EIectron/BATF7-Brushed-FC/README.md

# BATF7-Brushed-FC
 STM32F722 Based brushed flight controller board
