EIectron/BATF7-Brushed-FC/Hardware/IMAGEs/BATF7_SVG/bottom.png

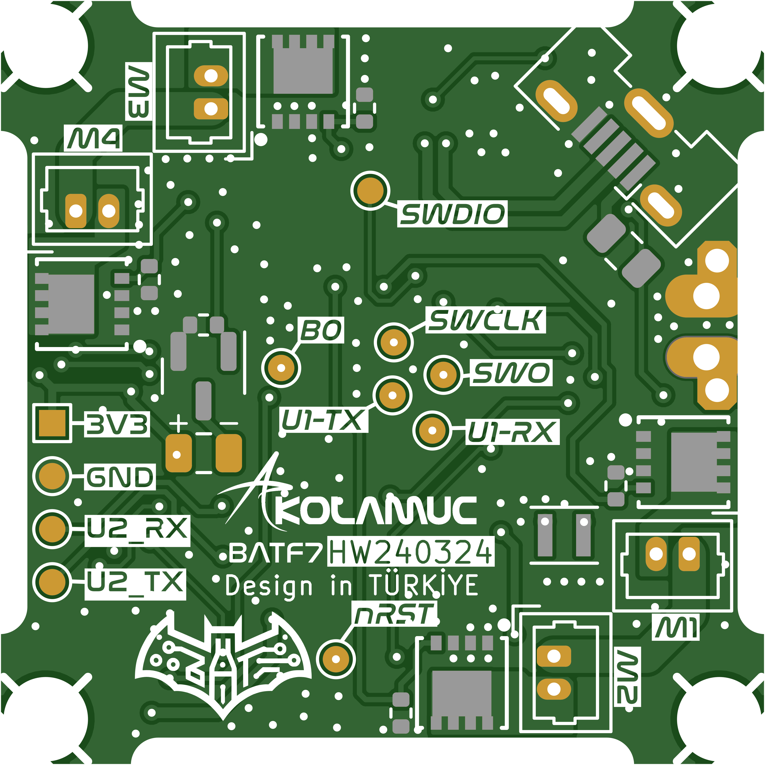
Hardware/IMAGEs/BATF7_SVG/bottom.png
