EIectron/BATF7-Brushed-FC/Hardware/IMAGEs/BATF7_SVG/top.png

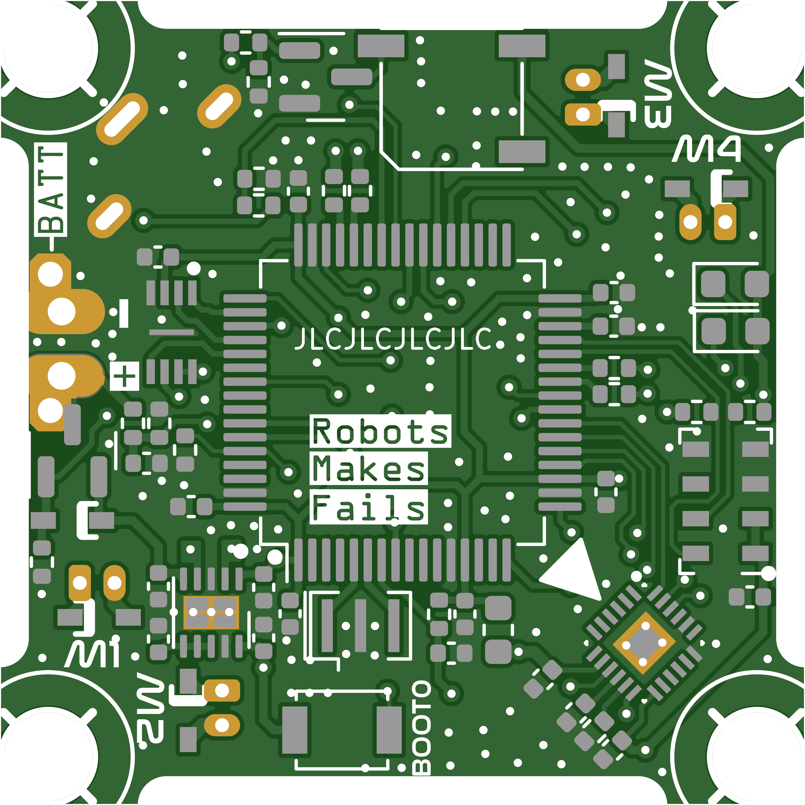
Hardware/IMAGEs/BATF7_SVG/top.png
