EIectron/BATF7-Brushed-FC/Hardware/IMAGEs/Render/Bot.png

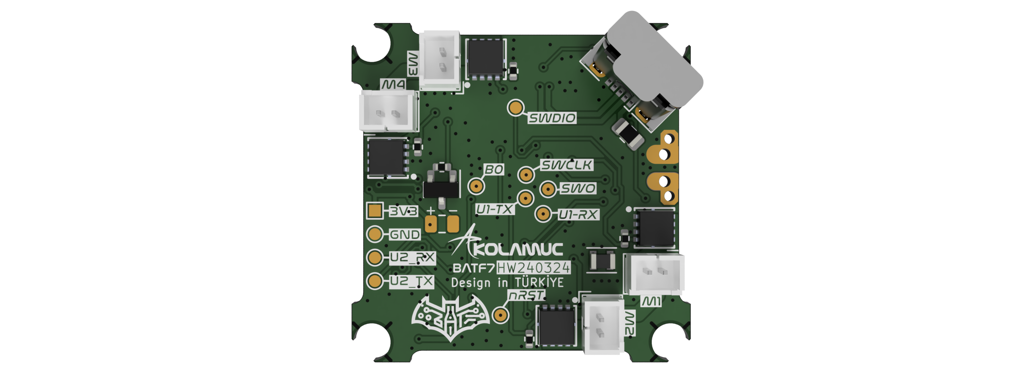
Hardware/IMAGEs/Render/Bot.png
