EIectron/BATF7-Brushed-FC/Hardware/IMAGEs/Render/Top.png

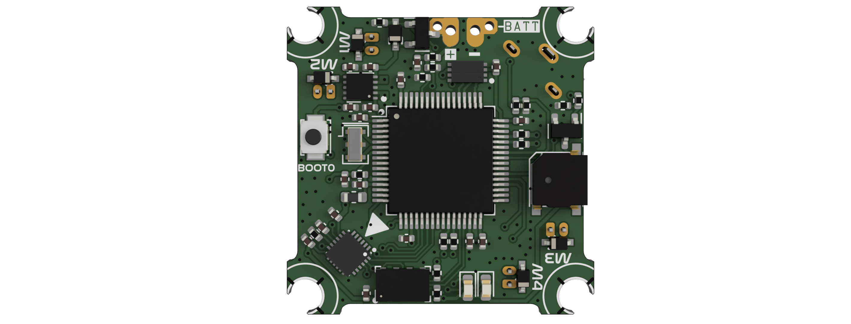
Hardware/IMAGEs/Render/Top.png
