EIectron/BATF7-Brushed-FC/Hardware/IMAGEs/SIS434DN-PSUM.PNG

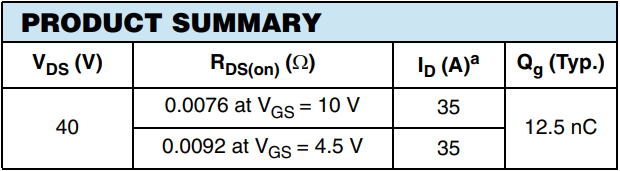
Hardware/IMAGEs/SIS434DN-PSUM.PNG
