EIectron/BATF7-Brushed-FC/Hardware/3D/Coilcraft_XFL4015 v11.step

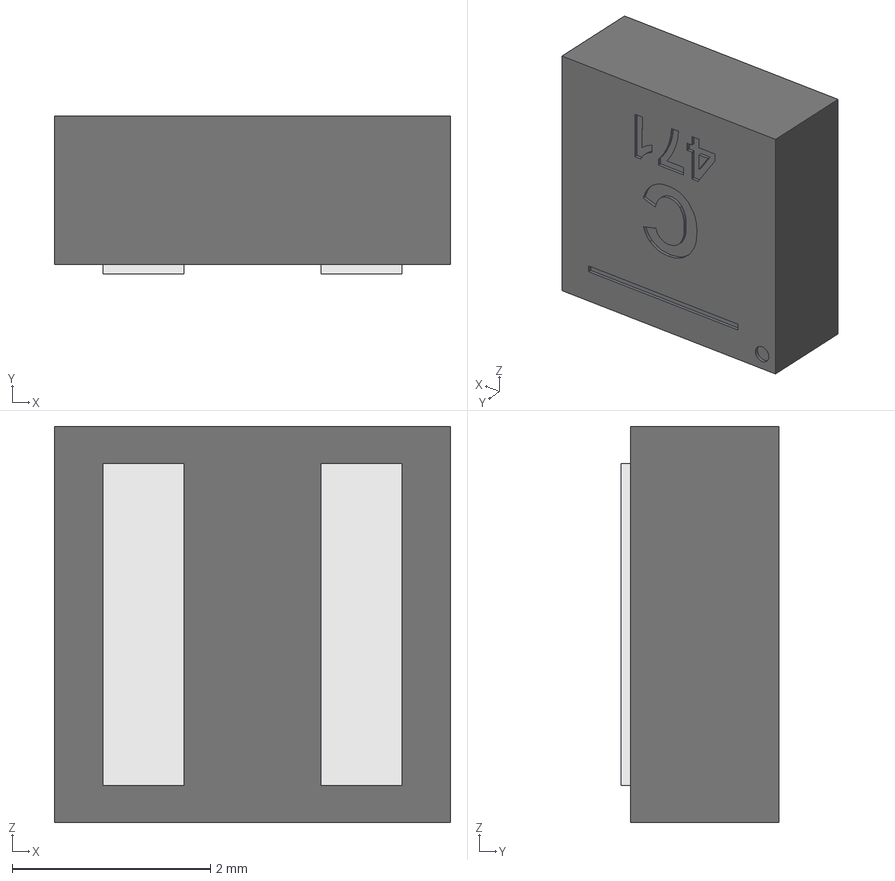
[picture p7: CAD file, 2024-04-10]
Hardware/3D/Coilcraft_XFL4015 v11.step
4.00 x 1.60 x 4.00 mm
base
