EIectron/BATF7-Brushed-FC/Hardware/3D/JST - GH - Thru (V) - 2Pin - 1.25mm.stp

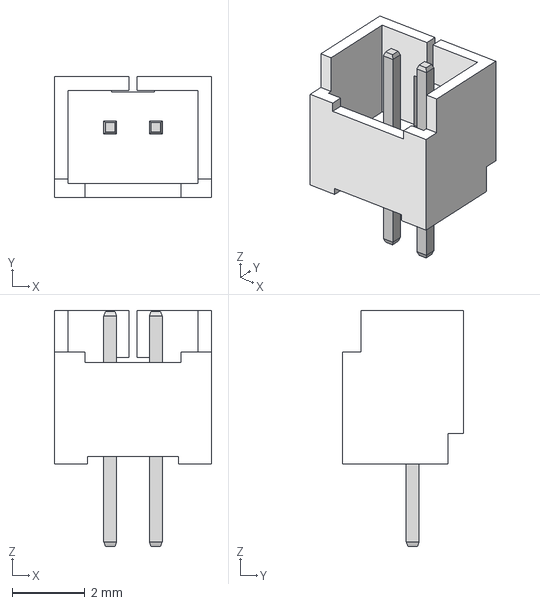
[picture p8: CAD file, 2024-04-10]
Hardware/3D/JST - GH - Thru (V) - 2Pin - 1.25mm.stp
4.32 x 3.33 x 6.48 mm
