EIectron/BATF7-Brushed-FC/Hardware/3D/DFN8_6x5.STEP

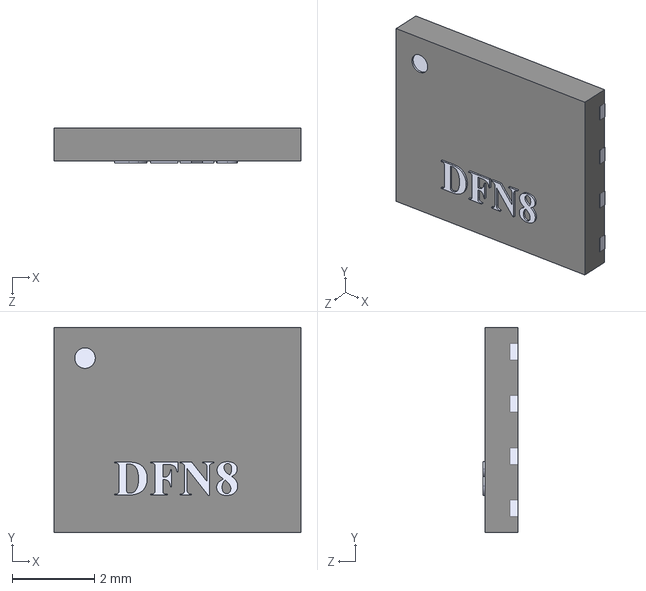
[picture p9: CAD file, 2024-04-10]
Hardware/3D/DFN8_6x5.STEP
6.01 x 5.00 x 0.855 mm
