EIectron/BATF7-Brushed-FC/Hardware/3D/ABMT-801-RC.STEP

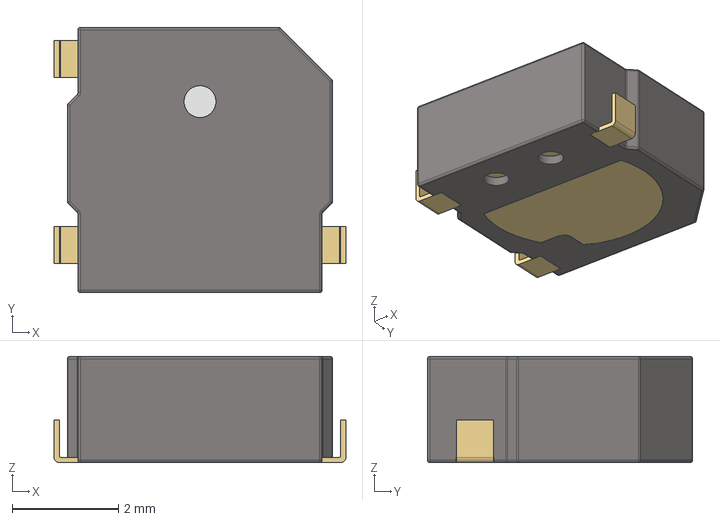
[picture p10: CAD file, 2024-04-10]
Hardware/3D/ABMT-801-RC.STEP
5.50 x 5.00 x 2.00 mm
