EIectron/BATF7-Brushed-FC/Hardware/3D/MPU-6500.STEP

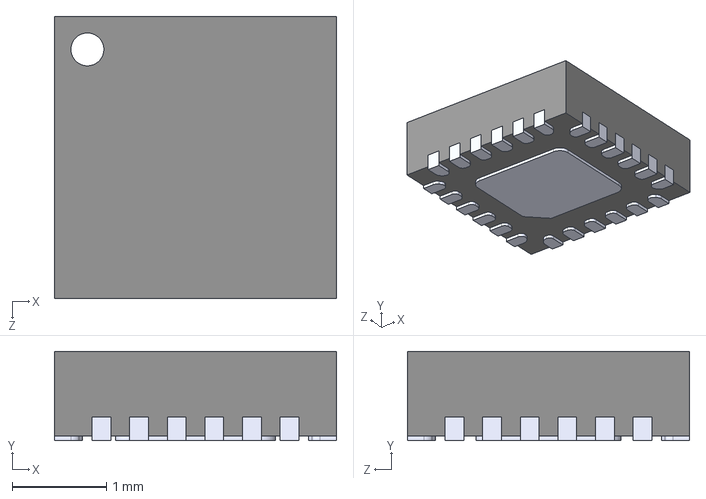
[picture p11: CAD file, 2024-04-10]
Hardware/3D/MPU-6500.STEP
3.00 x 0.95 x 3.00 mm
