EIectron/BATF7-Brushed-FC/Hardware/3D/FDMA410NZ.step

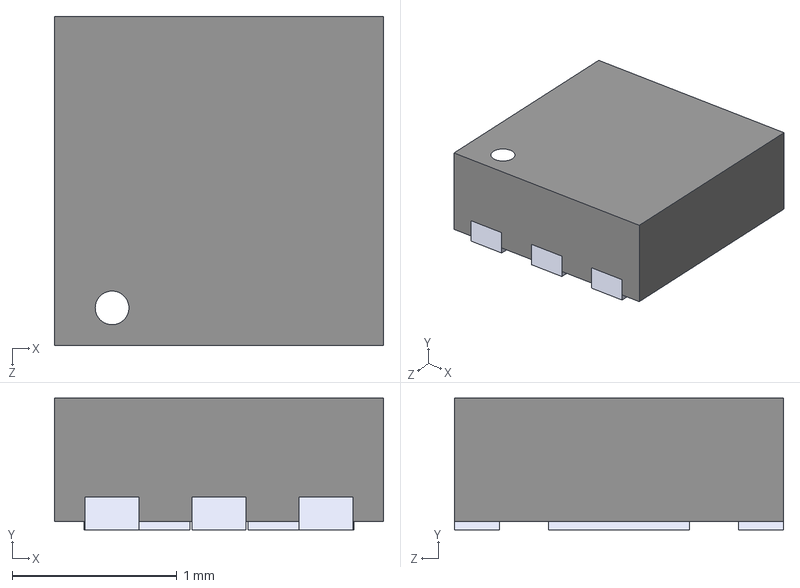
[picture p12: CAD file, 2024-04-10]
Hardware/3D/FDMA410NZ.step
2.00 x 0.8 x 2.00 mm
