EIectron/BATF7-Brushed-FC/Hardware/3D/Molex-105133-0031.stp

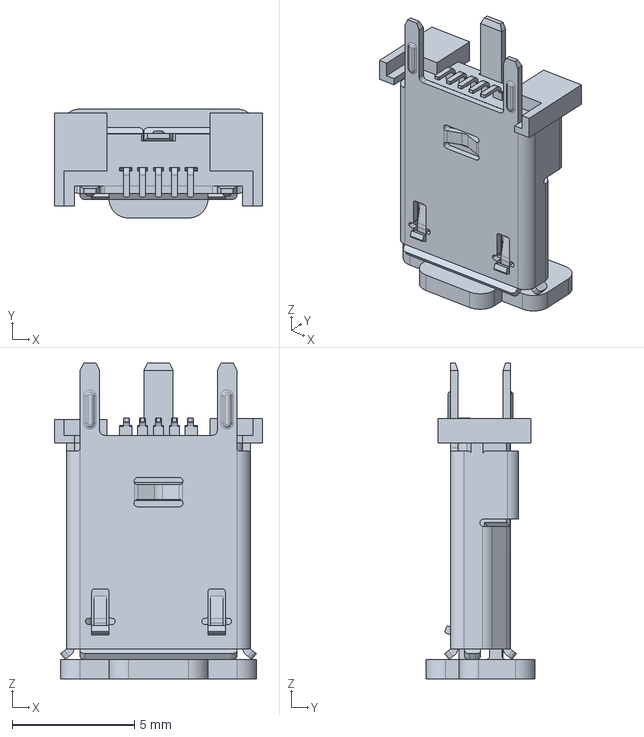
[picture p13: CAD file, 2024-04-10]
Hardware/3D/Molex-105133-0031.stp
8.50 x 4.45 x 12.9 mm
