EIectron/BATF7-Brushed-FC/Hardware/3D/JST - GH - Thru (R) - 2Pin - 1.25mm.stp

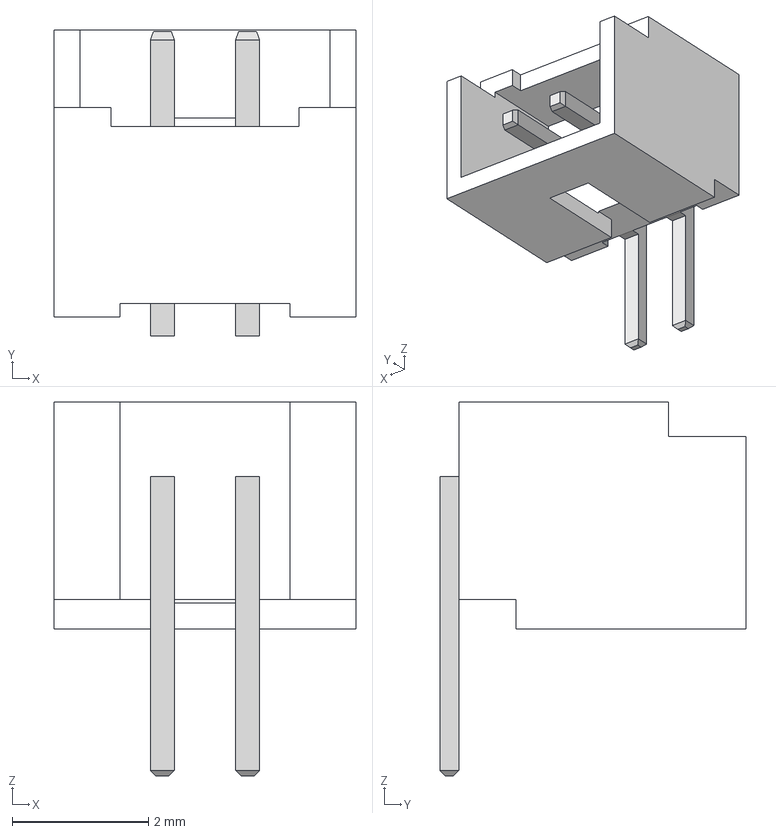
[picture p14: CAD file, 2024-04-10]
Hardware/3D/JST - GH - Thru (R) - 2Pin - 1.25mm.stp
4.43 x 4.50 x 5.49 mm
