EIectron/BATF7-Brushed-FC/Hardware/3D/W25X05CLUXIG.STEP

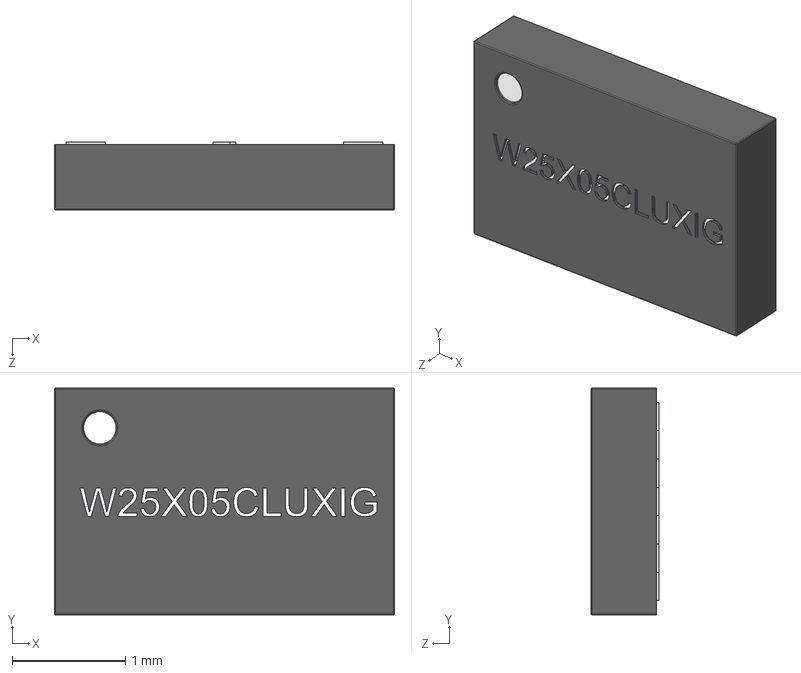
[picture p15: CAD file, 2024-04-10]
Hardware/3D/W25X05CLUXIG.STEP
3.00 x 2.00 x 0.6 mm
