EIectron/BATF7-Brushed-FC/Hardware/3D/SIS434DN-T1-GE3.STEP

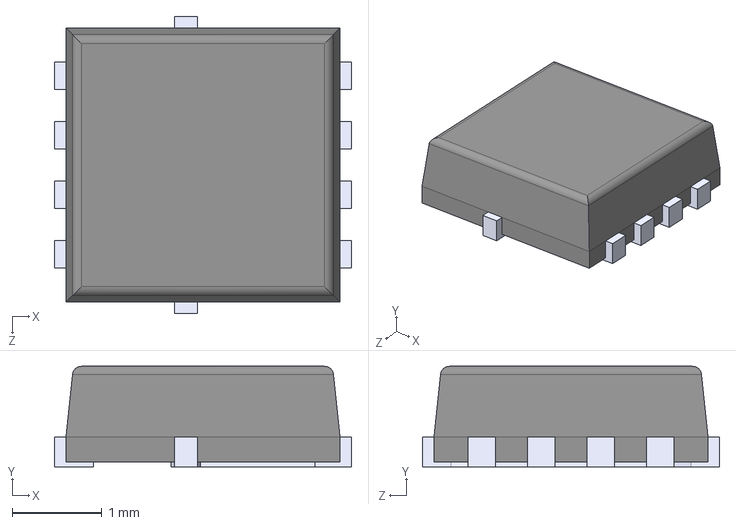
[picture p16: CAD file, 2024-04-10]
Hardware/3D/SIS434DN-T1-GE3.STEP
3.30 x 1.12 x 3.30 mm
