EIectron/BATF7-Brushed-FC/Hardware/3D/TPS63031DSKT.STEP

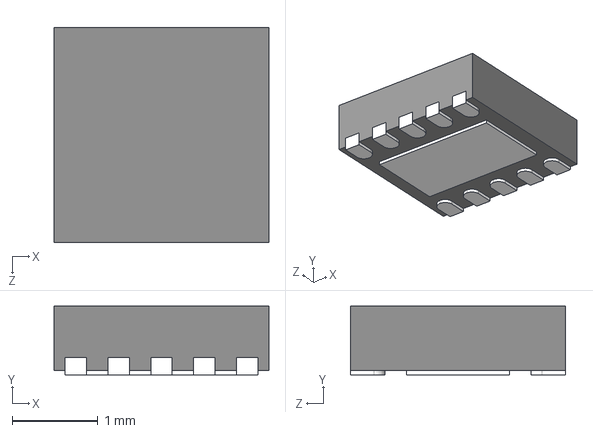
[picture p17: CAD file, 2024-04-10]
Hardware/3D/TPS63031DSKT.STEP
2.50 x 0.8 x 2.50 mm
