EIectron/BATF7-Brushed-FC/Hardware/BATF7.pdf

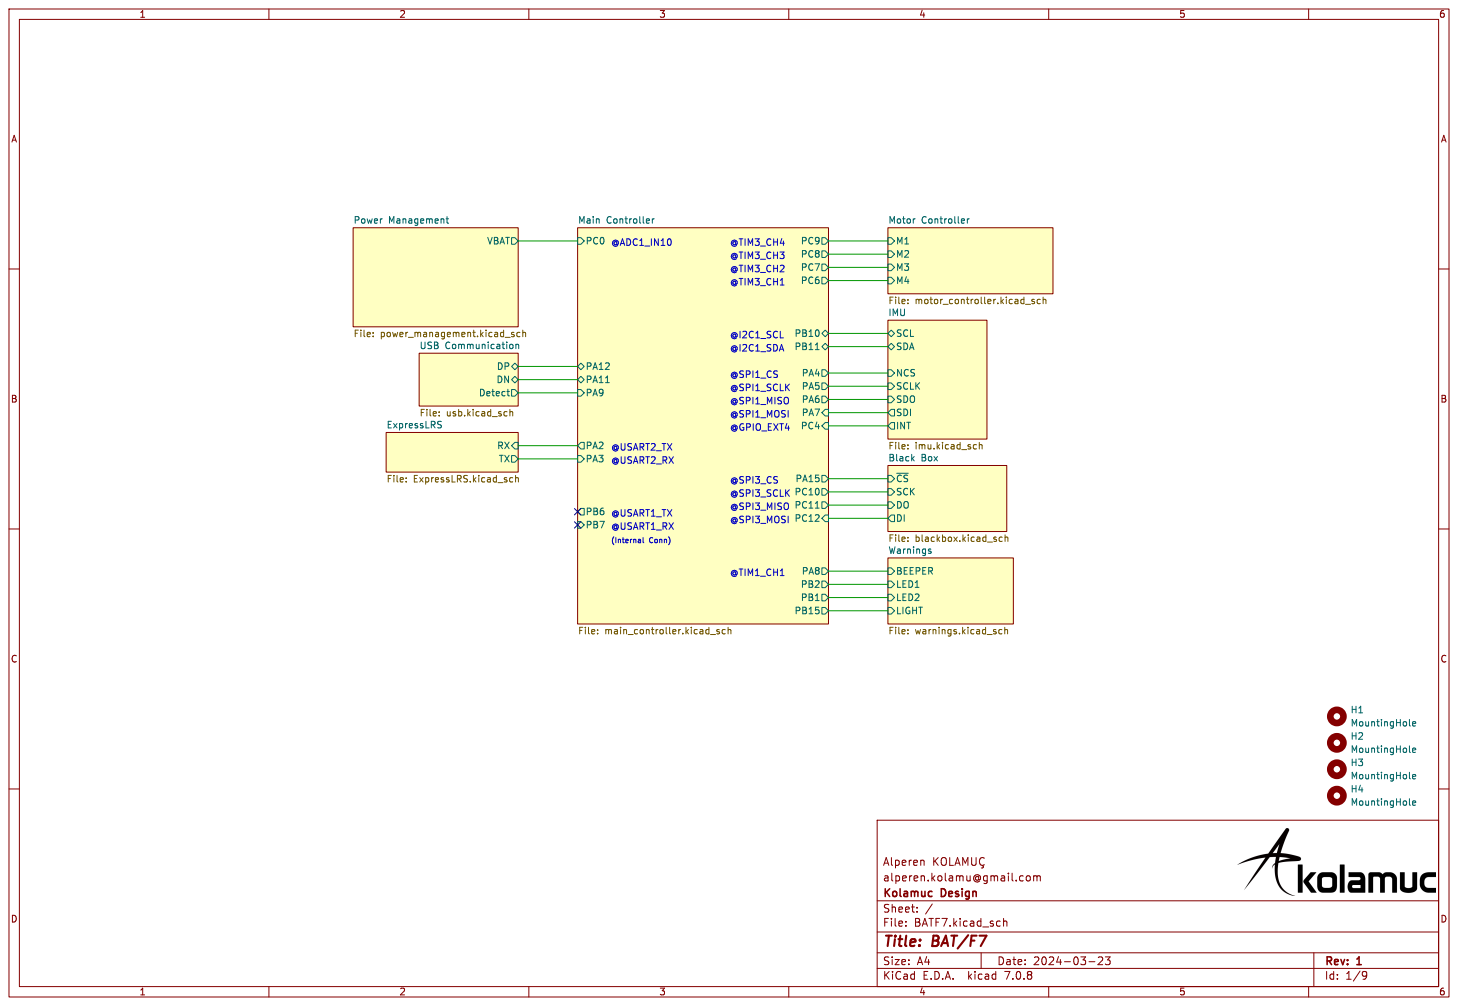
[picture p18: page 1]

VBAT Power Management File: power_management.kicad_schRX

LIGHT Warnings File: warnings.kicad_sch

Alperen þÿKOLAMUÇ
alperen.kolamu@gmail.com

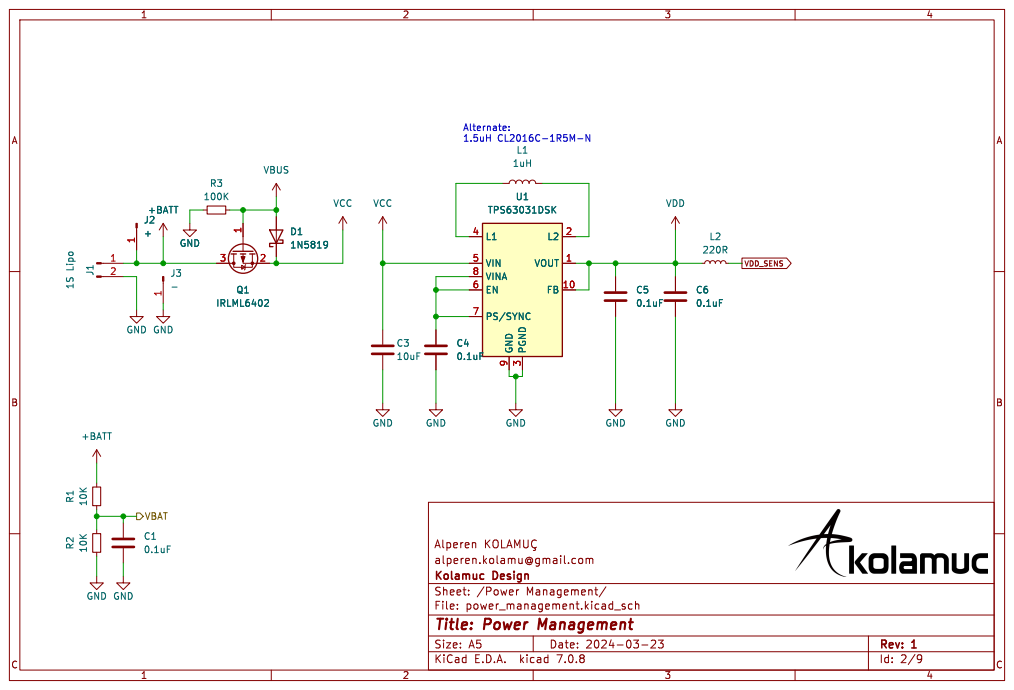
[picture p19: page 2]

alperen.kolamu@gmail.com
power_management.kicad_sch Sheet: /Power Design Management/ Kolamuc Id: 2/9 Title: Power Management File:

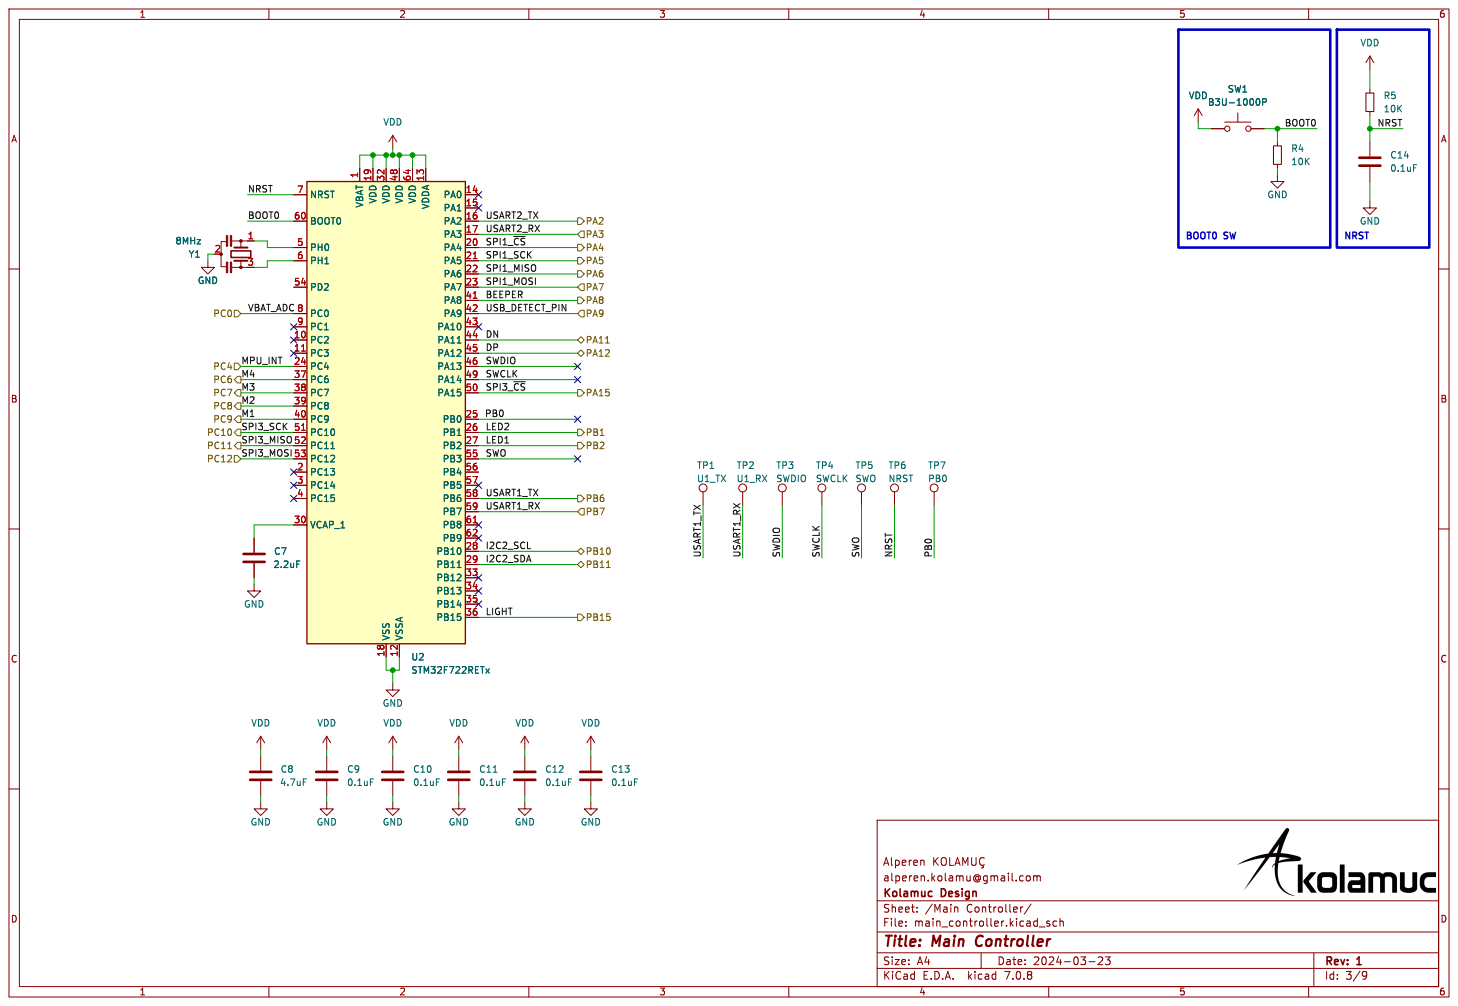
[picture p20: page 3]

1 PC2 10 PC3 11 VSSA 12 VDDA 13 PA0 14 PA1 15 PA2 16 PA3 17 VSS 18 VDD 19 PC13 2 PA4 20 PA5 21 PA6 22 PA7 23 PC4 24 PB0 25 PB1 26 PB2 27 PB10 28 PB11 29 PC14 3 VCAP_1 30 VDD 32 PB12 33 PB13 34 PB14 35 PB15 36 PC6 37 PC7 38 PC8 39 PC15 4 PC9 40 PA8 41 PA9 42 PA10 43 PA11 44 PA12 45 PA13 46 VDD 48 PA14 49 PH0 5 PA15 50 PC10 51 PC11 52 PC12 53 PD2 54 PB3 55 PB4 56 PB5 57 PB6 58 PB7 59 PH1 6 BOOT0 60 PB8 61 PB9 62 VDD 64 NRST 7 PC0 8 PC1 9 U2STM32F722RETx GND GND

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

Alperen þÿKOLAMUÇ
alperen.kolamu@gmail.com

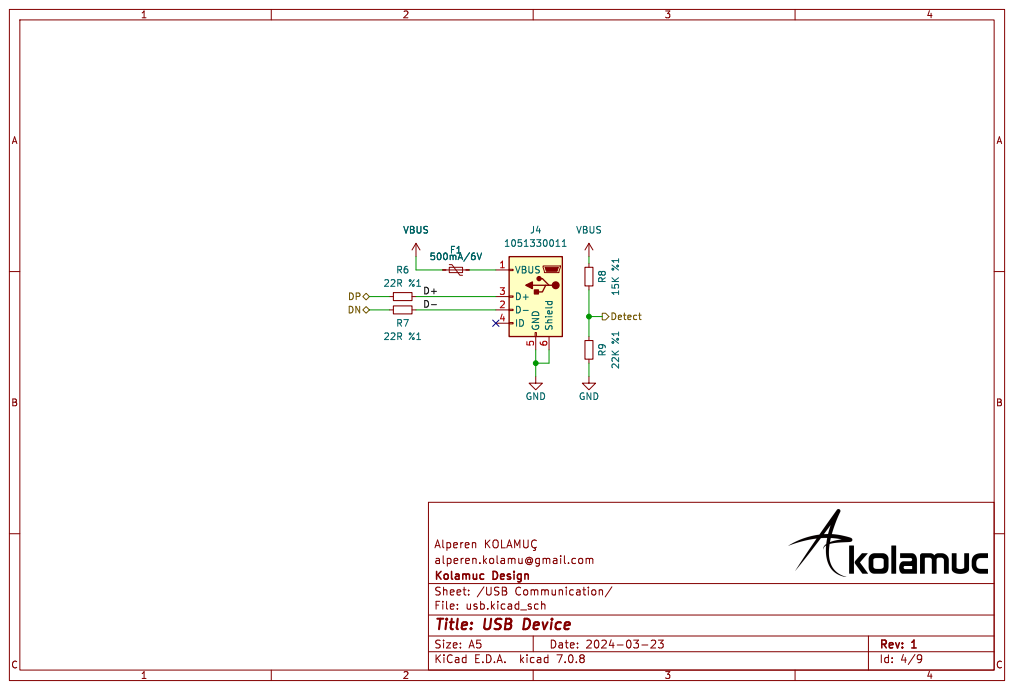
[picture p21: page 4]

alperen.kolamu@gmail.com

Id: 4/9 Title: USB Device

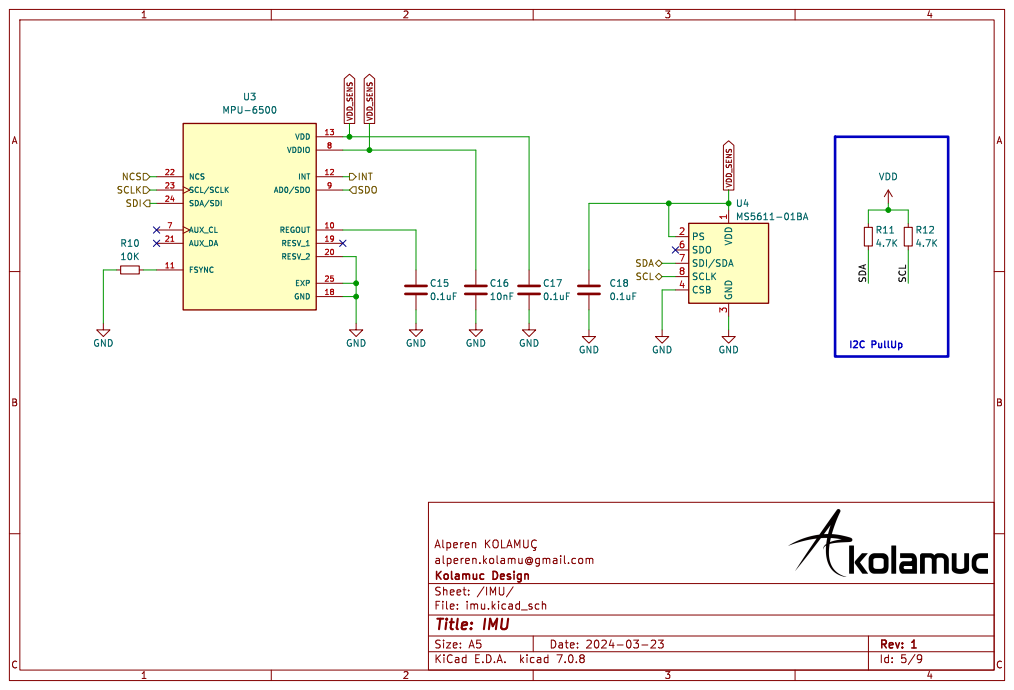
[picture p22: page 5]

3 CSB 4 SDO 6 SDI/SDA 7 SCLK 8 U4 MS5611-01BA R11

alperen.kolamu@gmail.com

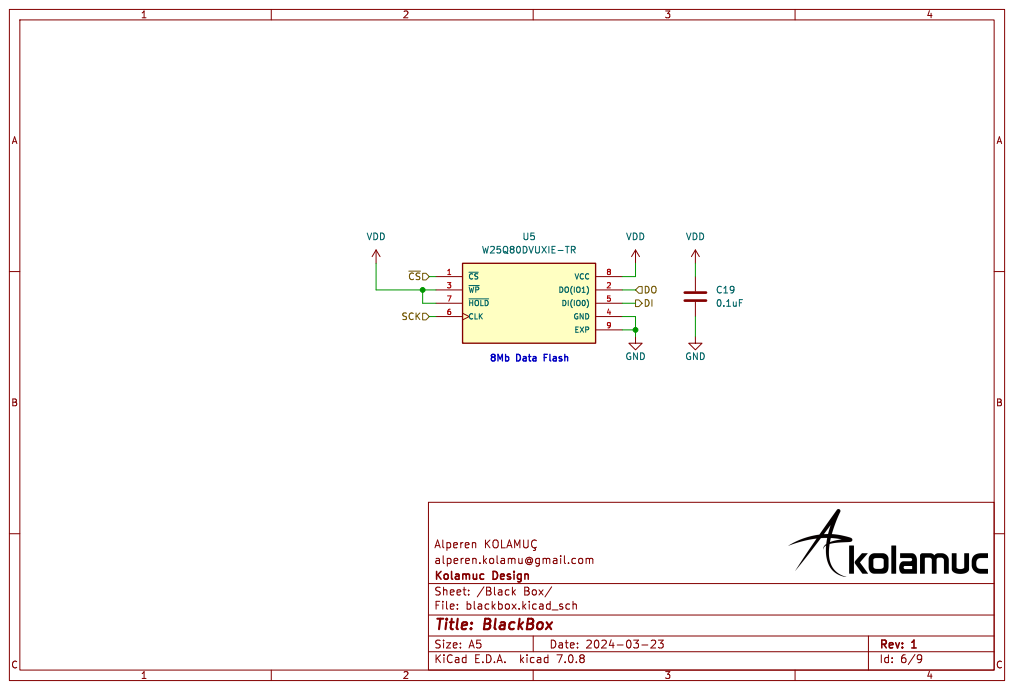
[picture p23: page 6]

alperen.kolamu@gmail.com

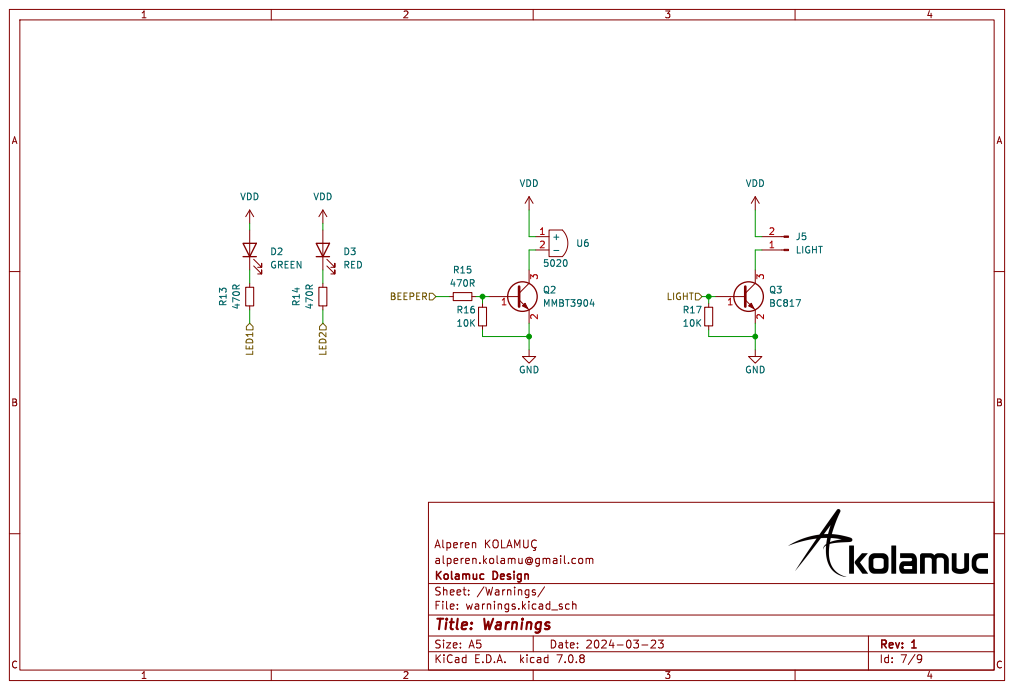
[picture p24: page 7]

alperen.kolamu@gmail.com

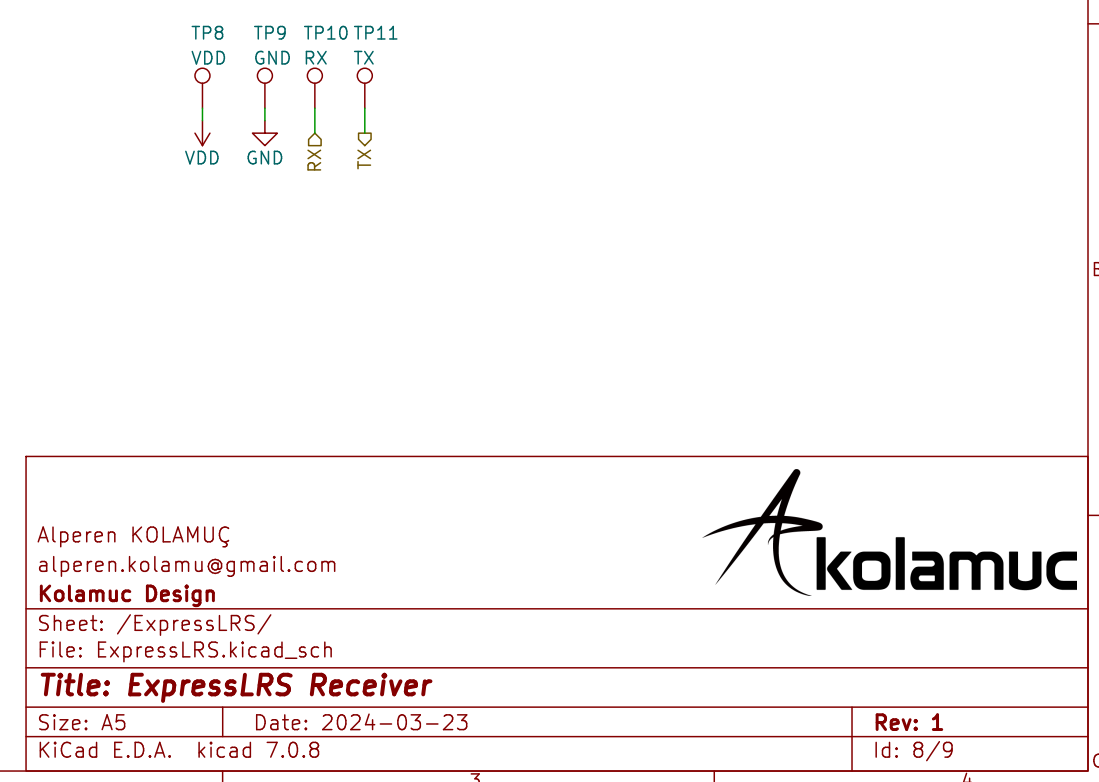
[picture p25: page 8]

alperen.kolamu@gmail.com
ExpressLRS.kicad_sch Sheet: /ExpressLRS/ Kolamuc | Design Id: 8/9 Title: ExpressLRS Receiver File:

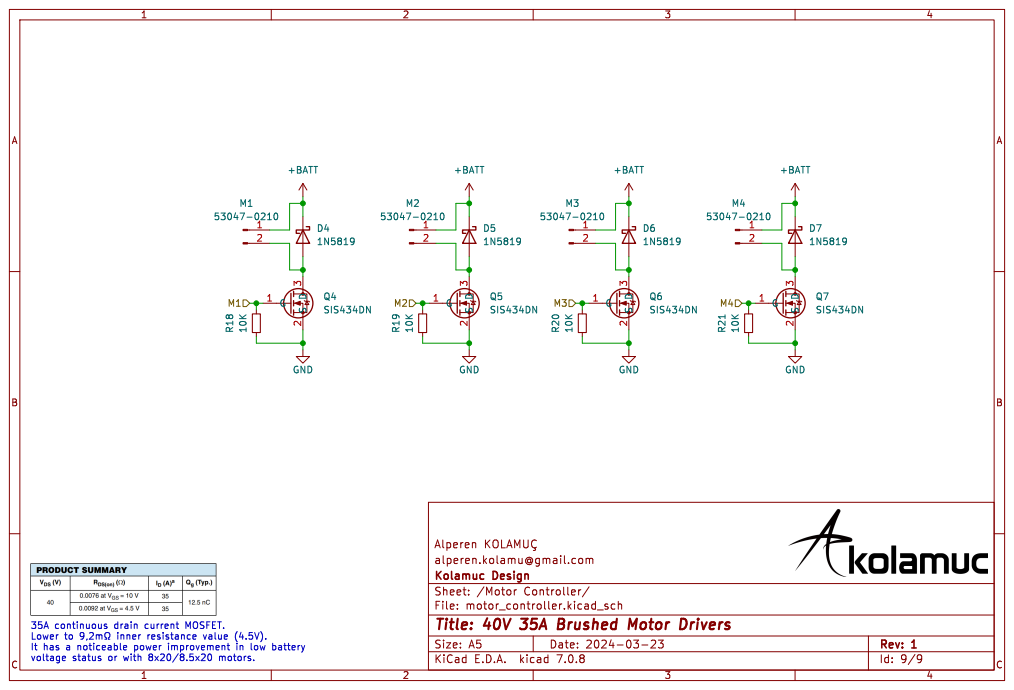
[picture p26: page 9]

alperen.kolamu@gmail.com

Id: 9/9 Title: 40V 35A Brushed Motor Drivers
