EIectron/BATF7-Brushed-FC/Hardware/BATF7.kicad_pcb

## KiCad design Hardware/BATF7.kicad_pcb (2024-05-07)

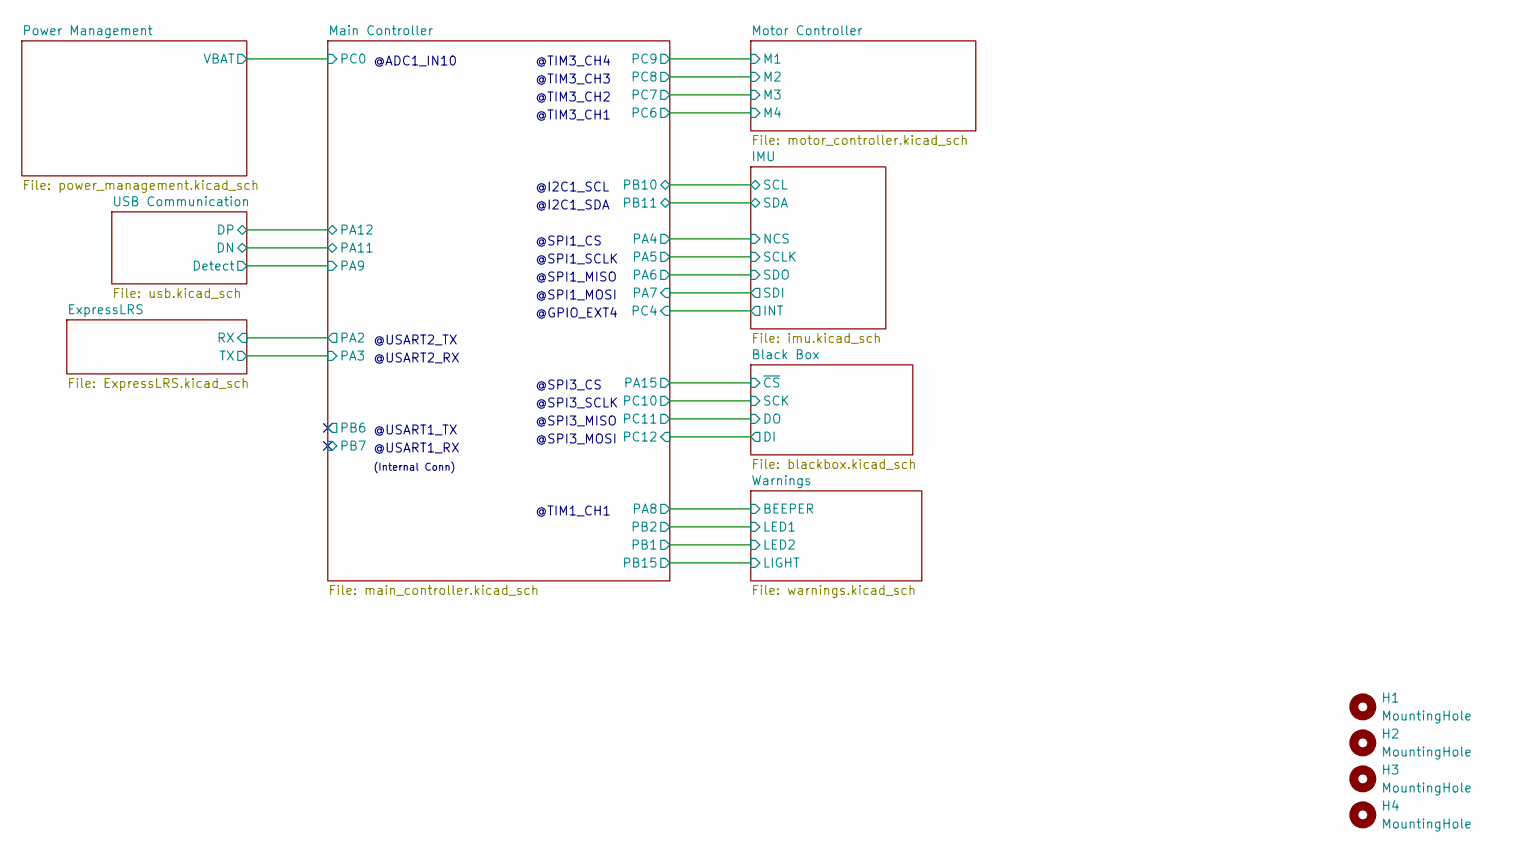
[picture p27: schematic BATF7.kicad_sch, BAT/F7]

Parts:
H1, H2, H3, H4: MountingHole; MH32

Notes on the sheet:
@ADC1_IN10
@USART1_RX
@TIM3_CH4
@USART2_TX
(Internal Conn)
@SPI3_SCLK
@USART1_TX
@TIM3_CH1
@SPI3_MOSI
@TIM1_CH1
@SPI3_MISO
@SPI1_MOSI
@I2C1_SDA
@TIM3_CH2
@I2C1_SCL
@SPI3_CS
@USART2_RX
@SPI1_MISO
@SPI1_CS
@TIM3_CH3
@SPI1_SCLK
@GPIO_EXT4

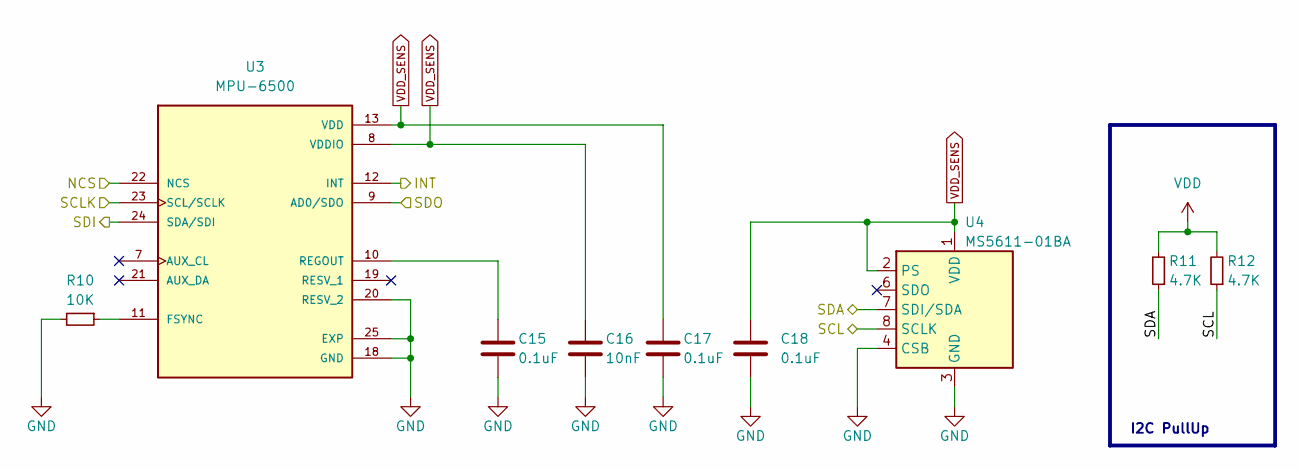
[picture p28: schematic imu.kicad_sch]

Parts:
C15, C17, C18: 0.1uF; C_0402_1005Metric
C16: 10nF; C_0402_1005Metric
R10: 10K; R_0402_1005Metric
R11, R12: 4.7K; R_0402_1005Metric
U3: MPU-6500; MPU6500
U4: MS5611-01BA; LGA-8_3x5mm_P1.25mm

Connections:
/IMU/SCL: R12.1, U4.8 (SCLK); also elsewhere on the board
/IMU/SDA: R11.1, U4.7 (SDI/SDA); also elsewhere on the board
/Main Controller/MPU_INT: U3.12 (INT); also elsewhere on the board
/Main Controller/SPI1_MISO: U3.9 (AD0/SDO); also elsewhere on the board
/Main Controller/SPI1_MOSI: U3.24 (SDA/SDI); also elsewhere on the board
/Main Controller/SPI1_SCK: U3.23 (SCL/SCLK); also elsewhere on the board
/Main Controller/SPI1_~CS: U3.22 (NCS); also elsewhere on the board
GND: C15.2, C16.1, C17.2, C18.2, R10.2, U3.18 (GND), U3.20 (RESV_2), U3.25 (EXP), U4.3 (GND), U4.4 (CSB), U4.5 (CSB); also elsewhere on the board
unnamed: R10.1, U3.11 (FSYNC)
unnamed: C15.1, U3.10 (REGOUT)
VDD: R11.2, R12.2; also elsewhere on the board
VDD_SENS: C16.2, C17.1, C18.1, U3.8 (VDDIO), U3.13 (VDD), U4.1 (VDD), U4.2 (PS); also elsewhere on the board

Notes on the sheet:
I2C PullUp

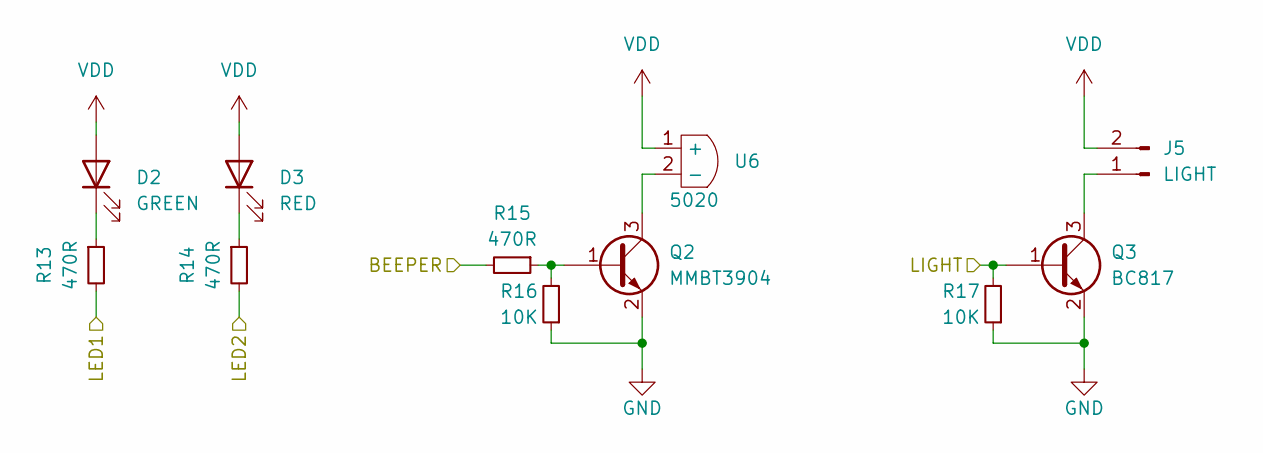
[picture p29: schematic warnings.kicad_sch]

Parts:
D2: GREEN; LED_0603_1608Metric
D3: RED; LED_0603_1608Metric
J5: LIGHT; C_0805_2012Metric
Q2: MMBT3904; SOT-23
Q3: BC817; SOT-23
R13, R14, R15: 470R; R_0402_1005Metric
R16, R17: 10K; R_0402_1005Metric
U6: 5020; ABMT-801-RC_PIEZO

Connections:
/Main Controller/BEEPER: R15.2; also elsewhere on the board
/Main Controller/LED1: R13.2; also elsewhere on the board
/Main Controller/LED2: R14.2; also elsewhere on the board
/Main Controller/LIGHT: Q3.1 (B), R17.2; also elsewhere on the board
GND: Q2.2 (E), Q3.2 (E), R16.1, R17.1; also elsewhere on the board
unnamed: D2.1 (K), R13.1
unnamed: D3.1 (K), R14.1
unnamed: J5.1, Q3.3 (C)
unnamed: Q2.1 (B), R15.1, R16.2
unnamed: Q2.3 (C), U6.2 (-)
VDD: D2.2 (A), D3.2 (A), J5.2, U6.1 (+); also elsewhere on the board

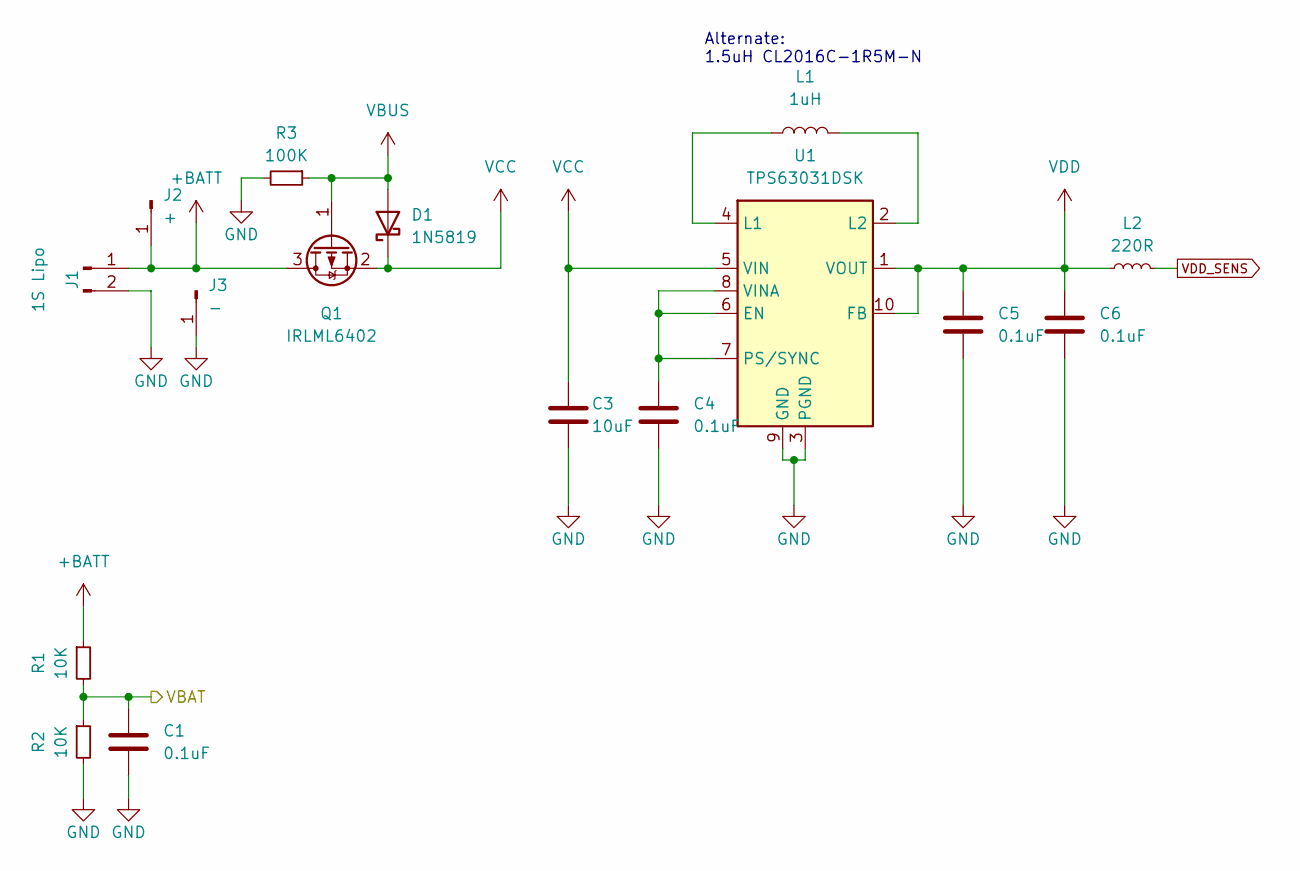
[picture p30: schematic power_management.kicad_sch, Power Management]

Parts:
C1, C4, C5, C6: 0.1uF; C_0402_1005Metric
C3: 10uF; C_0402_1005Metric
D1: 1N5819; SOD-323
J1: 1S Lipo; 1x02-Long-Pad
J2: +; TestPoint_THTPad_1.0x1.0mm_Drill0.5mm
J3: -; TestPoint_THTPad_1.0x1.0mm_Drill0.5mm
L1: 1uH; L_Murata_DFE201610P
L2: 220R; L_0603_1608Metric
Q1: IRLML6402; SOT-23
R1, R2: 10K; R_0402_1005Metric
R3: 100K; R_0402_1005Metric
U1: TPS63031DSK; WSON-10-1EP_2.5x2.5mm_P0.5mm_EP1.2x2mm

Connections:
+BATT: J1.1, J2.1, Q1.3 (D), R1.1; also elsewhere on the board
/Main Controller/VBAT_ADC: C1.1, R1.2, R2.1; also elsewhere on the board
GND: C1.2, C3.2, C4.2, C5.2, C6.2, J1.2, J3.1, R2.2, R3.2, U1.3 (PGND), U1.9 (GND), U1.11 (PGND); also elsewhere on the board
unnamed: C4.1, U1.6 (EN), U1.7 (PS/SYNC), U1.8 (VINA)
unnamed: L1.1, U1.4 (L1)
unnamed: L1.2, U1.2 (L2)
VBUS: D1.2 (A), Q1.1 (G), R3.1; also elsewhere on the board
VCC: C3.1, D1.1 (K), Q1.2 (S), U1.5 (VIN)
VDD: C5.1, C6.1, L2.1, U1.1 (VOUT), U1.10 (FB); also elsewhere on the board
VDD_SENS: L2.2; also elsewhere on the board

Notes on the sheet:
Alternate: 1.5uH CL2016C-1R5M-N

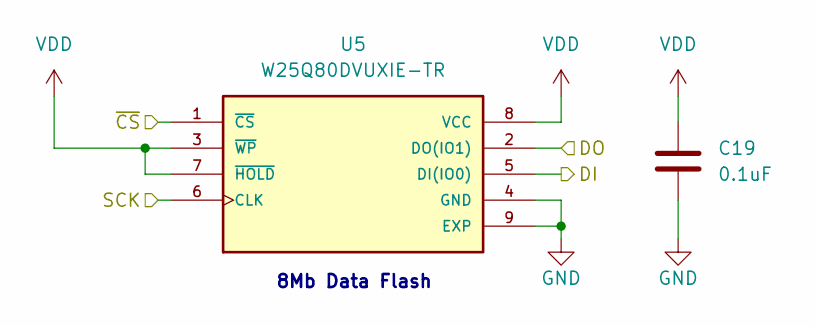
[picture p31: schematic blackbox.kicad_sch]

Parts:
C19: 0.1uF; C_0402_1005Metric
U5: W25Q80DVUXIE-TR; 8-USON

Connections:
/Main Controller/SPI3_MISO: U5.2 (DO(IO1)); also elsewhere on the board
/Main Controller/SPI3_MOSI: U5.5 (DI(IO0)); also elsewhere on the board
/Main Controller/SPI3_SCK: U5.6 (CLK); also elsewhere on the board
/Main Controller/SPI3_~CS: U5.1 (~CS); also elsewhere on the board
GND: C19.2, U5.4 (GND), U5.9 (EXP); also elsewhere on the board
VDD: C19.1, U5.3 (~WP), U5.7 (~HOLD), U5.8 (VCC); also elsewhere on the board

Notes on the sheet:
8Mb Data Flash

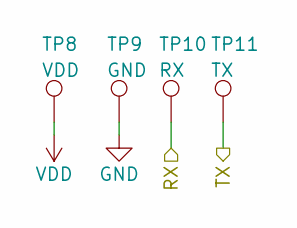
[picture p32: schematic ExpressLRS.kicad_sch, ExpressLRS Receiver]

Parts:
TP8: VDD; TestPoint_Pad_1.0x1.0mm
TP9: GND; TestPoint_Pad_D1.0mm
TP10: RX; TestPoint_Pad_D1.0mm
TP11: TX; TestPoint_Pad_D1.0mm

Connections:
/Main Controller/USART2_RX: TP11.1; also elsewhere on the board
/Main Controller/USART2_TX: TP10.1; also elsewhere on the board
GND: TP9.1; also elsewhere on the board
VDD: TP8.1; also elsewhere on the board

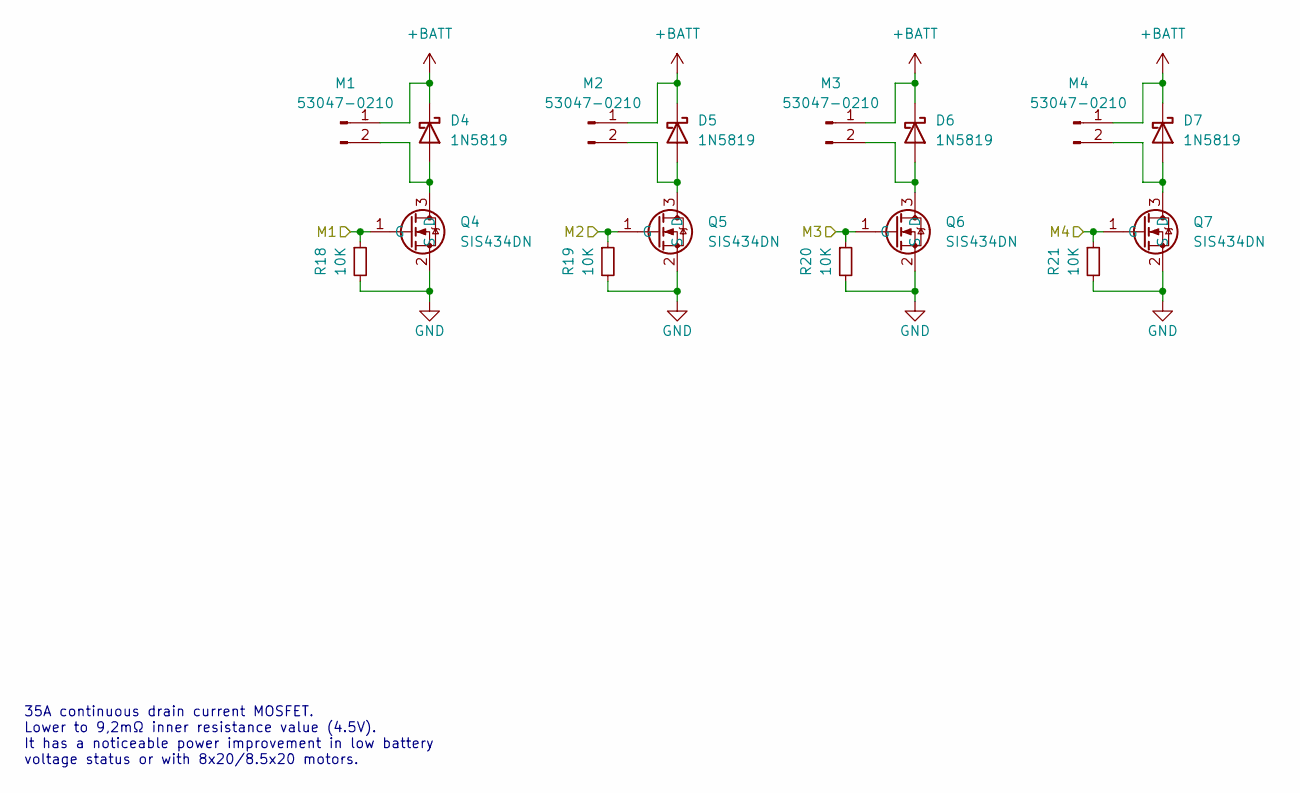
[picture p33: schematic motor_controller.kicad_sch, 40V 35A Brushed Motor Drivers]

Parts:
D4, D5, D6, D7: 1N5819; SOD-323
M1, M2, M3, M4: 53047-0210; Molex_PicoBlade_53047-0210_1x02_P1.25mm_Vertical
Q4, Q5, Q6, Q7: SIS434DN; PPAK1212-8
R18, R19, R20, R21: 10K; R_0402_1005Metric

Connections:
+BATT: D4.1 (K), D5.1 (K), D6.1 (K), D7.1 (K), M1.1, M2.1, M3.1, M4.1; also elsewhere on the board
/Main Controller/M1: Q4.1 (G), R18.1; also elsewhere on the board
/Main Controller/M2: Q5.1 (G), R19.1; also elsewhere on the board
/Main Controller/M3: Q6.1 (G), R20.1; also elsewhere on the board
/Main Controller/M4: Q7.1 (G), R21.1; also elsewhere on the board
GND: Q4.2 (S), Q5.2 (S), Q6.2 (S), Q7.2 (S), R18.2, R19.2, R20.2, R21.2; also elsewhere on the board
unnamed: D4.2 (A), M1.2, Q4.3 (D)
unnamed: D5.2 (A), M2.2, Q5.3 (D)
unnamed: D6.2 (A), M3.2, Q6.3 (D)
unnamed: D7.2 (A), M4.2, Q7.3 (D)

Notes on the sheet:
35A continuous drain current MOSFET. Lower to 9,2mΩ inner resistance value (4.5V). It has a noticeable power improvement in low battery voltage status or with 8x20/8.5x20 motors.

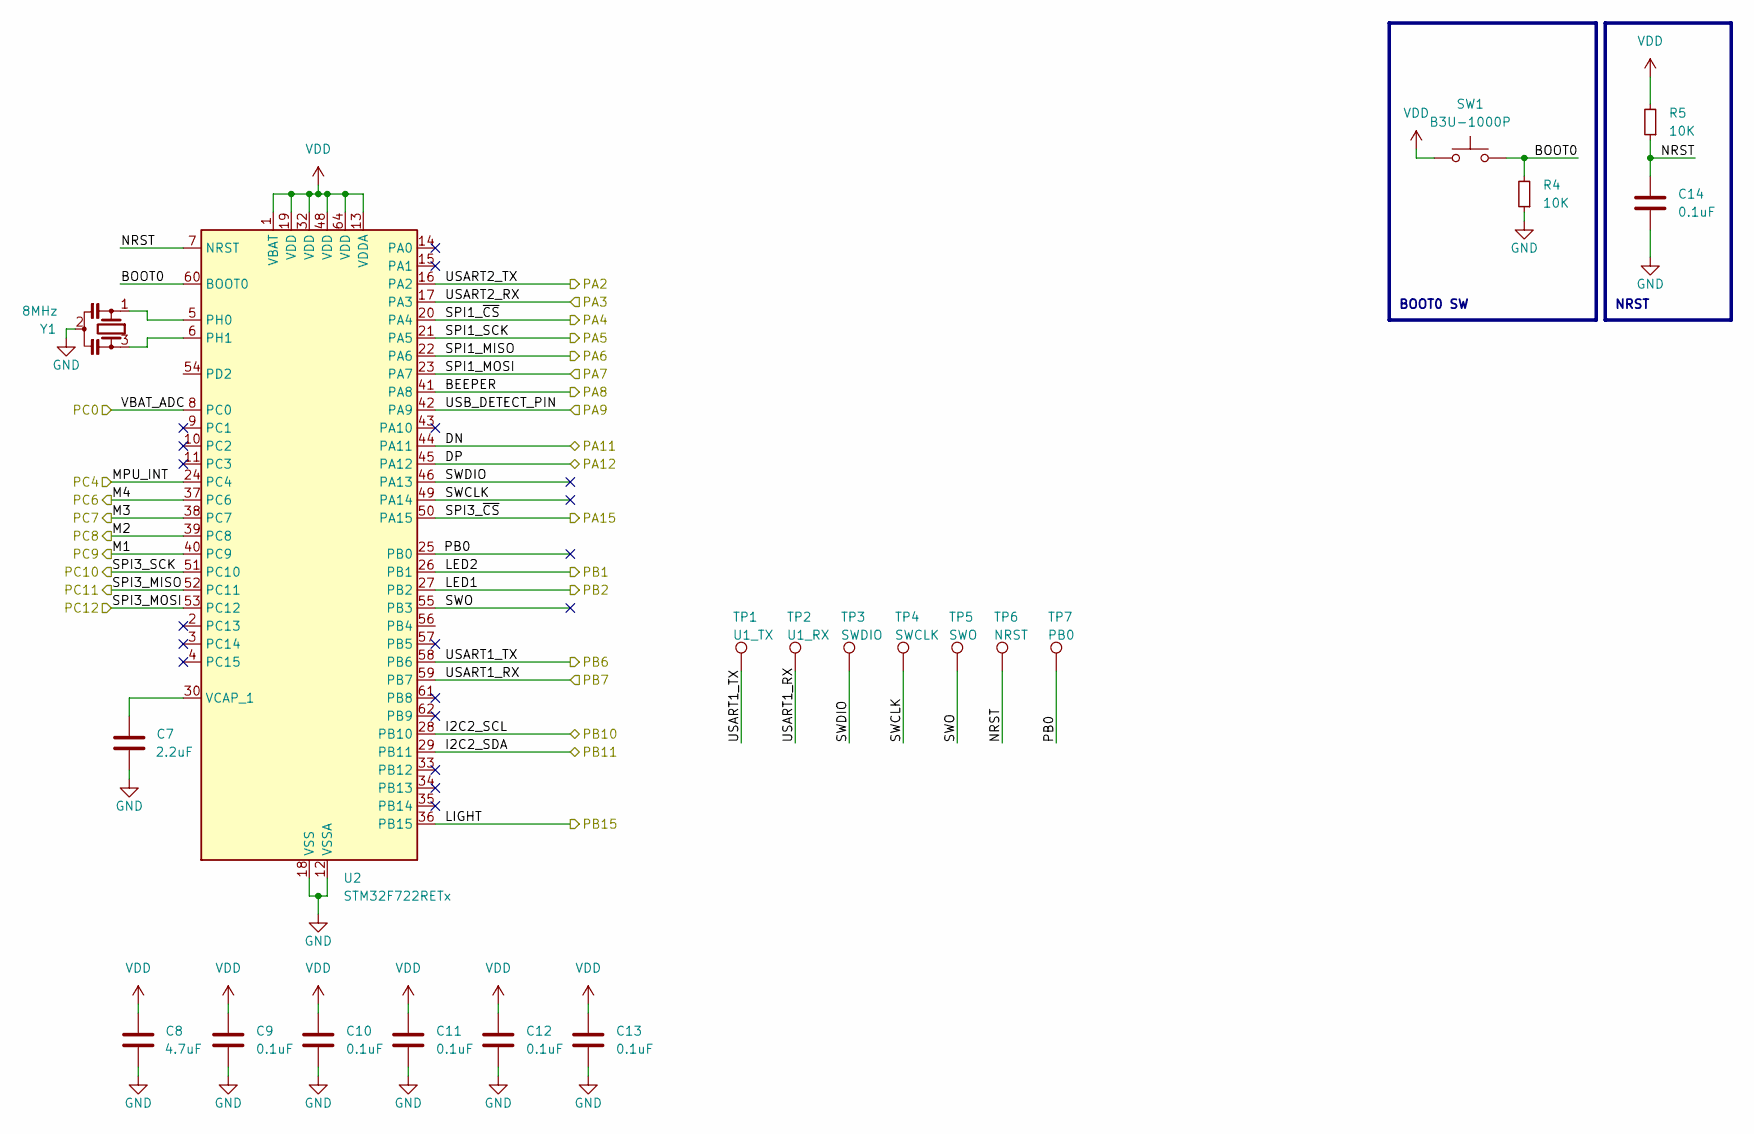
[picture p34: schematic main_controller.kicad_sch, Main Controller]

Parts:
C7: 2.2uF; C_0402_1005Metric
C8: 4.7uF; C_0402_1005Metric
C9, C10, C11, C12, C13, C14: 0.1uF; C_0402_1005Metric
R4, R5: 10K; R_0402_1005Metric
SW1: B3U-1000P; SW_SPST_B3U-1000P
TP1: U1_TX; TestPoint_Pad_D1.0mm
TP2: U1_RX; TestPoint_Pad_D1.0mm
TP3: SWDIO; TestPoint_Pad_D1.0mm
TP4: SWCLK; TestPoint_Pad_D1.0mm
TP5: SWO; TestPoint_Pad_D1.0mm
TP6: NRST; TestPoint_Pad_D1.0mm
TP7: PB0; TestPoint_Pad_D1.0mm
U2: STM32F722RETx; LQFP-64_10x10mm_P0.5mm
Y1: 8MHz; Resonator_SMD_Murata_CSTxExxV-3Pin_3.0x1.1mm

Connections:
/IMU/SCL: U2.28 (PB10); also elsewhere on the board
/IMU/SDA: U2.29 (PB11); also elsewhere on the board
/Main Controller/BEEPER: U2.41 (PA8); also elsewhere on the board
/Main Controller/BOOT0: R4.2, SW1.2, U2.60 (BOOT0)
/Main Controller/DN: U2.44 (PA11); also elsewhere on the board
/Main Controller/DP: U2.45 (PA12); also elsewhere on the board
/Main Controller/LED1: U2.27 (PB2); also elsewhere on the board
/Main Controller/LED2: U2.26 (PB1); also elsewhere on the board
/Main Controller/LIGHT: U2.36 (PB15); also elsewhere on the board
/Main Controller/M1: U2.40 (PC9); also elsewhere on the board
/Main Controller/M2: U2.39 (PC8); also elsewhere on the board
/Main Controller/M3: U2.38 (PC7); also elsewhere on the board
/Main Controller/M4: U2.37 (PC6); also elsewhere on the board
/Main Controller/MPU_INT: U2.24 (PC4); also elsewhere on the board
/Main Controller/NRST: C14.1, R5.1, TP6.1, U2.7 (NRST)
/Main Controller/PB0: TP7.1, U2.25 (PB0)
/Main Controller/SPI1_MISO: U2.22 (PA6); also elsewhere on the board
/Main Controller/SPI1_MOSI: U2.23 (PA7); also elsewhere on the board
/Main Controller/SPI1_SCK: U2.21 (PA5); also elsewhere on the board
/Main Controller/SPI1_~CS: U2.20 (PA4); also elsewhere on the board
/Main Controller/SPI3_MISO: U2.52 (PC11); also elsewhere on the board
/Main Controller/SPI3_MOSI: U2.53 (PC12); also elsewhere on the board
/Main Controller/SPI3_SCK: U2.51 (PC10); also elsewhere on the board
/Main Controller/SPI3_~CS: U2.50 (PA15); also elsewhere on the board
/Main Controller/SWCLK: TP4.1, U2.49 (PA14)
/Main Controller/SWDIO: TP3.1, U2.46 (PA13)
/Main Controller/SWO: TP5.1, U2.55 (PB3)
/Main Controller/USART1_RX: TP2.1, U2.59 (PB7)
/Main Controller/USART1_TX: TP1.1, U2.58 (PB6)
/Main Controller/USART2_RX: U2.17 (PA3); also elsewhere on the board
/Main Controller/USART2_TX: U2.16 (PA2); also elsewhere on the board
/Main Controller/USB_DETECT_PIN: U2.42 (PA9); also elsewhere on the board
/Main Controller/VBAT_ADC: U2.8 (PC0); also elsewhere on the board
GND: C7.2, C8.2, C9.2, C10.2, C11.2, C12.2, C13.2, C14.2, R4.1, U2.12 (VSSA), U2.18 (VSS), U2.31 (VSS), U2.47 (VSS), U2.63 (VSS), Y1.2; also elsewhere on the board
unnamed: U2.5 (PH0), Y1.1
unnamed: U2.6 (PH1), Y1.3
unnamed: C7.1, U2.30 (VCAP_1)
VDD: C8.1, C9.1, C10.1, C11.1, C12.1, C13.1, R5.2, SW1.1, U2.1 (VBAT), U2.13 (VDDA), U2.19 (VDD), U2.32 (VDD), U2.48 (VDD), U2.64 (VDD); also elsewhere on the board

Notes on the sheet:
NRST
BOOT0 SW

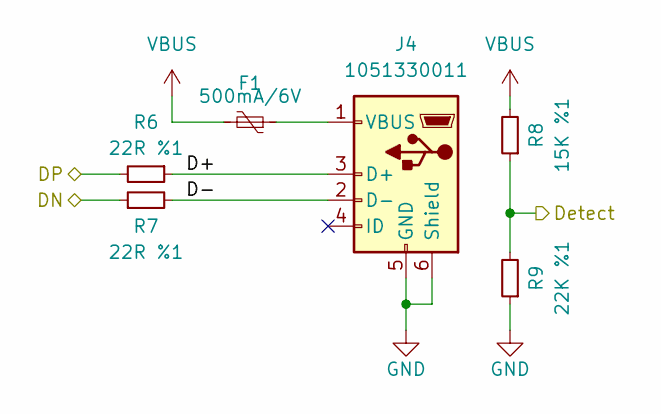
[picture p35: schematic usb.kicad_sch, USB Device]

Parts:
F1: 500mA/6V; Fuse_0805_2012Metric
J4: 1051330011; USB_Micro-B_Molex-105133-0031
R6, R7: 22R %1; R_0402_1005Metric
R8: 15K %1; R_0402_1005Metric
R9: 22K %1; R_0402_1005Metric

Connections:
/Main Controller/DN: R7.1; also elsewhere on the board
/Main Controller/DP: R6.2; also elsewhere on the board
/Main Controller/USB_DETECT_PIN: R8.1, R9.2; also elsewhere on the board
/USB Communication/D+: J4.3 (D+), R6.1
/USB Communication/D-: J4.2 (D-), R7.2
GND: J4.5 (GND), J4.6 (Shield), R9.1; also elsewhere on the board
unnamed: F1.1, J4.1 (VBUS)
VBUS: F1.2, R8.2; also elsewhere on the board

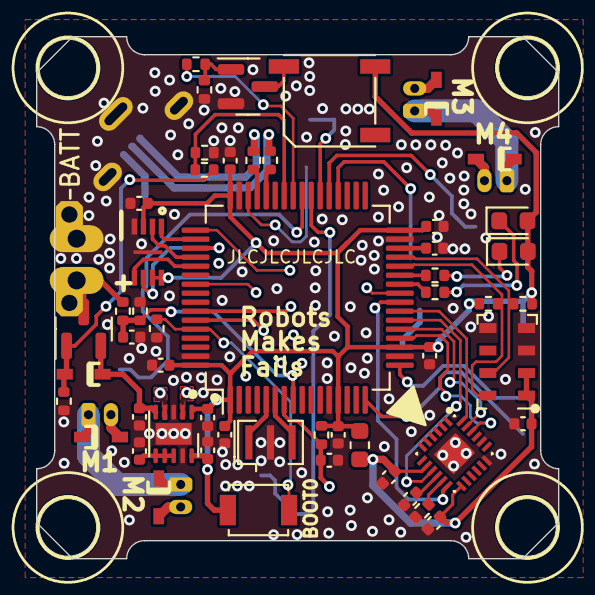
[picture p36: board BATF7.kicad_pcb from above]

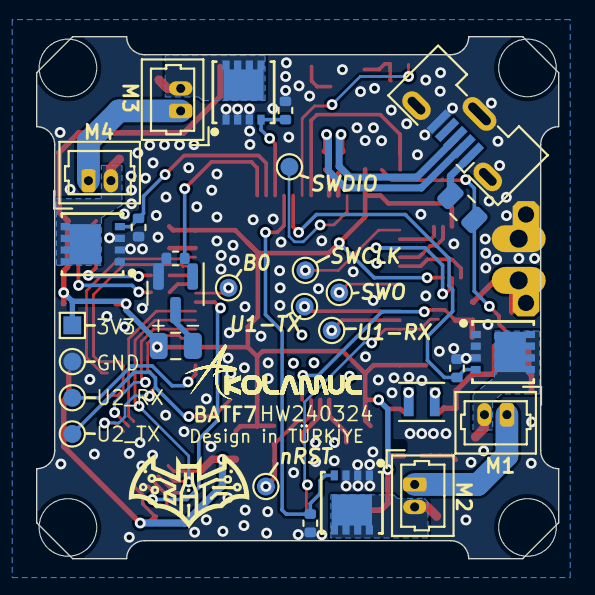
[picture p37: board BATF7.kicad_pcb from below]

Board: 4 copper layers, 29.0 x 29.0 mm, 88 parts (29 on the bottom side), 59 nets.
