EIectron/BATF7-Brushed-FC/(notices)

Notices in the files:
Software/BATF7/config.h:
Public License as published by the Free Software Foundation,
either version 3 of the License, or (at your option) any later
Hardware/3D/Molex-105133-0031.stp:
FILE_NAME( 'e:/temp/worker_113/temp/exporttempdir_8436_1146_w1N4L/format_0/1051330031.stp', '2022-02-20T07:51:13', ( 'License CC BY-ND 4.0' ), ( 'CADENAS' ), ' ', 'PARTsolutions', ' ' );
